johnbaikie/desk-hud/doc/img/preview_launches_recent.png

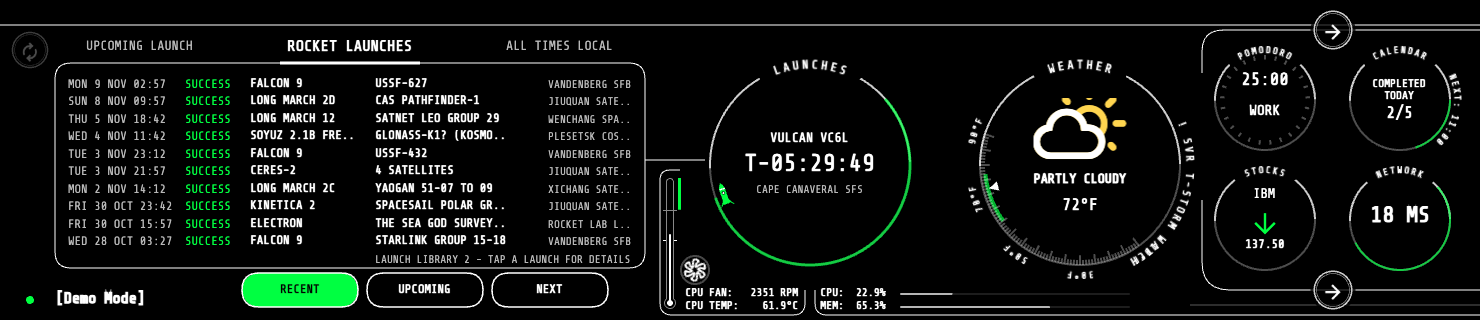
doc/img/preview_launches_recent.png
