johnbaikie/desk-hud/doc/stl/desk-hud-stand-lens-down.stl

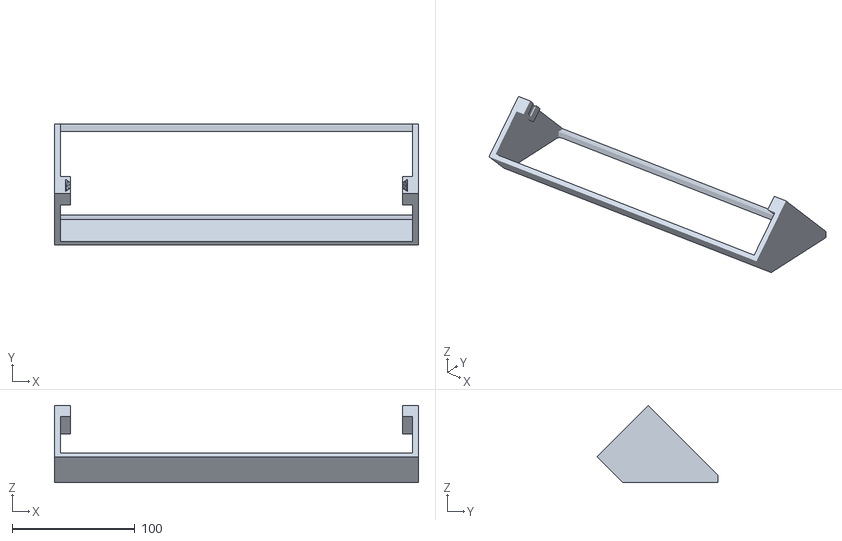
[picture p31: CAD file, 2026-11-07]
doc/stl/desk-hud-stand-lens-down.stl
297.0 x 98.8 x 62.9
