johnbaikie/desk-hud/doc/stl/desk-hud-stand-bar-fit-test.stl

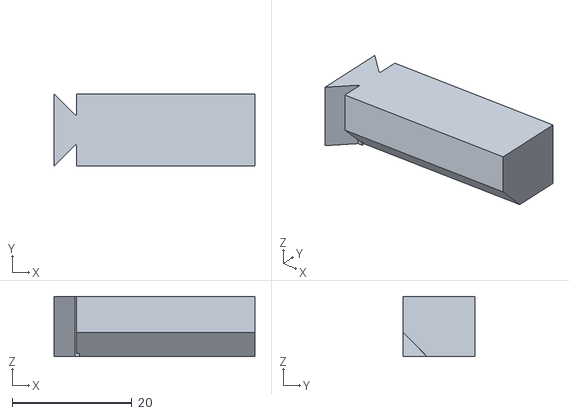
[picture p32: CAD file, 2026-11-07]
doc/stl/desk-hud-stand-bar-fit-test.stl
33.5 x 12.0 x 10.0
