johnbaikie/desk-hud/(commit log)

2026-10-27 Always use mocked distance sensor (no GPIO sensor installed)
2026-10-28 Change grey outline lines to white
    Border frame, room preview, covers diagrams, fan turbines, calendar
    divider and forecast separators now draw in white. Chart gridlines,
    dark border bars, grey text and fills are unchanged.
2026-10-28 Remove decorative hex counters from main screen
    The status labels regenerated a random hex string every frame,
    forcing two text re-renders and texture uploads per frame. They now
    stay blank unless statusLeftText/statusRightText is set.
2026-10-28 Switch to Share Tech Mono font with white uppercase text
    Replace the decorative Major Mono Display font with the more readable
    Share Tech Mono (bundled locally). Make all text white and render it
    uppercase to match the previous HUD look.
2026-10-28 Add create-widget skill and fix widget guide
    - Add .claude/skills/create-widget with templates, registration steps,
    current visual style, config handling and verification workflow
    - Point to the skill from CLAUDE.md
    - Fix widget guide: use Chart (style 'bars') instead of nonexistent
    BarChart, and the ShareTechMono font
2026-10-28 Fix right-side widgets ignoring taps after an interrupted drag
    ScrollContainer and TimezonePreview enlarged their invisible hit box
    100x on pointerdown and only shrank it on pointerup. If the touch was
    cancelled or the screen removed mid-drag, the box stayed enlarged and
    swallowed all taps to the right of it. Track drags with
    globalpointermove instead, and end them on pointerup, pointerupoutside,
    pointercancel and removal.
2026-10-31 Align calendar day highlight with the current font and fix Sunday-start months
    The highlight used fixed spacing tuned for the old MajorMono font, so it
    drifted off the current day with ShareTechMono. Measure the font instead.
    Months starting on a Sunday also put day 1 under Monday.
2026-10-31 Add optional Fahrenheit units to the weather widget
    weather.units ("metric" or "imperial") selects the OpenWeatherMap units,
    the temperature labels and a matching dial range. Configs without it stay
    in Celsius.
2026-10-31 Show the next pomodoro session and add a skip button
    When idle the timer shows the session play will start ("next: break")
    instead of the one that just ended. Skip switches to the other session,
    cancelling a running one; stop now resets the same session. Old saved
    timer state is converted on load. Note timer state and the Google
    widgets in CLAUDE.md.
2026-10-31 Show the Pi 5 cooler's speed instead of a GPIO fan mode
    The fan on the Pi 5 fan header is controlled by the firmware, so read its
    speed and duty from the pwm-fan hwmon device and show it in the system
    panel. Remove the off/auto/on GPIO 14 fan switching and its tap control.
2026-10-31 Support several stock symbols, rotating every 20 minutes
    stockdata.symbol may be a list. Quotes for all symbols come from one
    request; daily history is fetched per symbol every 6 hours to stay within
    the free plan. The widget and history chart show one stock at a time,
    switching every 20 minutes, and the chart rescales for each stock.
    Restarts only refetch stale data.
2026-11-03 Switch the accent colour from Tron blue to Matrix green
    Replace 0x00d8ff with 0x00ff41 everywhere; text and lines stay white.
    Draw today's date in black over the green calendar highlight so it stays
    readable.
2026-11-03 Deploy to the Pi by its reserved IP and document the Pi setup
    deskhud.local does not resolve over mDNS on this network; the Pi now has
    a DHCP reservation. Note the pm2 watch scope, log rotation, Wi-Fi power
    saving and fan readout in CLAUDE.md.
2026-11-03 Remove touch diagnostics and the blank widget; document touch calibration
    The right-hand widgets ignored taps because touch was not rotated with the
    display; a libinput calibration matrix in the Pi's labwc rc.xml fixes it.
    The widget count was not the cause, so the blank placeholder goes too.
2026-11-03 Replace the stock chart with current figures and swipe between stocks
    The enlarged Stocks screen shows the selected stock's price, change since
    open, open/high/low, previous close, volume and 6-month range. Swiping up
    or down moves to the next or previous stock; the small circle follows the
    selection and still advances after 20 minutes without a swipe. The
    service passes the extra quote fields through.
2026-11-03 Save memory: simulate the distance sensor in-process, trim logs from cron
    The mock distance sensor ran as its own node process (~45 MB) printing a
    constant reading; push the readings from a timer in DistanceService
    instead. Add scripts/trim-pm2-logs.sh, run hourly from cron, to replace the
    pm2-logrotate module (~75 MB resident).
2026-11-03 Swipe the calendar main screen to see other days
    Swiping left/right on the Calendar or Outlook main screen moves through
    the next six days; the title shows the day and it returns to today after
    a minute. The Google service now loads a full week (timeMax, up to 250
    events) so later days aren't cut off.
2026-11-04 Add Rainbow Mode to the Accent widget: a random color per widget
    ACCENT is now a live binding that index.js switches before building each
    widget; components that draw after construction keep a copy of it.
2026-11-04 Add a Network widget: Wi-Fi signal, pings, DNS, dropouts and speed
    NetworkService samples every 30 s with local tools (ip route, ping to the
    router and 1.1.1.1, dns.lookup of the hosts the other services use,
    /proc/net/wireless), keeps 24 h of history in node-persist and runs a
    10 MB Cloudflare download test every 3 hours or on demand.
2026-11-05 Restyle outlines: rounded panel, pill tabs, smooth circles
    Replace the angular, notched frames with rounded shapes: a rounded main
    panel, pill-shaped tab buttons in one row, border lines with rounded
    corners instead of 45-degree jogs and zigzags, smooth widget circles
    without the |> <| title markers, and solid rounded progress bars.
    LineArt gains addRoundedSequence/roundCorners so lines still draw in.
2026-11-05 Show a sun-lit world map on the Date & Time TIME tab
    Replace the timezone strips with a dot-matrix world map (Natural Earth
    110m land, packed into a 1 KB bitmask): land is lit by the current sun
    position with a day/night line and a subsolar marker, home and the
    configured zones are marked with their local times, and home's sunrise,
    sunset and day length are shown. The server now sends the weather
    location as dateTime.location for the home marker.
2026-11-06 Add the Moon to the TIME tab's world map
    Show the current phase (picture, name, illumination and days to the next
    full or new moon) above home's sunrise and sunset, and mark the point
    where the Moon is overhead, drawn in its phase. Positions and phase come
    from the main terms of the lunar theory (about a degree).
2026-11-07 Add the 3D printed stand: guide, OpenSCAD source, STLs and images
    Adds doc/install_stand.md, the parametric doc/scad/desk-hud-stand.scad
    with a Makefile that exports every STL and runs the interference checks
    (collide, joint, clips_collide all pass), the six STLs in doc/stl and
    the guide's images. doc/install_case.md links to the new guide.
2026-11-07 Make the docs my own: new screenshots, README, setup guides and demo site
    - README rewritten for this version: every current widget with fresh
    demo-mode screenshots, a link to my demo, build/dev links and credits
    to the original project (MIT notice kept in LICENSE, my line added)
    - scripts/capture-screenshots.mjs regenerates the screenshots from the
    demo build at 1480x320 with a fixed clock (demo exposes window.deskHud)
    - Hardware and software guides rewritten for the Pi 5 / Trixie / labwc
    setup; scripts/setup-auto-updates.sh added for nightly OS updates
    - .github/workflows/demo.yml publishes the demo build to GitHub Pages
    - package.json and clone URLs point at johnbaikie/desk-hud; o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
2026-11-07 Add a Formula 1 widget: driver and constructor standings and the next race
    Data from Jolpica-F1 (the free Ergast successor, no key), refreshed hourly.
    Tabs for drivers, teams and the next race weekend with a countdown; the
    circle shows the championship leader and the season's progress. The
    screenshot script can now capture a subset of shots.
2026-11-07 Add an F1 car to the Formula 1 widget
    A small drawn car in the accent colour drives round the inside of the
    season-progress ring to the current round, and a larger one sits by the
    next race's countdown.
2026-11-07 F1 widget: browse the season's race weekends and every session's results
    The RACES tab (was NEXT RACE) shows one weekend at a time; swipe through
    the season. INFO keeps the circuit, countdown and session times; P1, P2,
    P3, SQ, SP, Q and GP show that session's classification from OpenF1
    (free historical data), matched to the Jolpica calendar by session type
    and start time. Results are fetched on request, spaced for OpenF1's rate
    limit and cached once a session is over. Demo mode gets the 2026
    calendar and made-up results.
2026-11-11 Switch off the Google features, keeping their code
    src/widgets/features.json gains a "google" switch, off for now because
    the Google project is unpublished and its sign-in expires weekly. Off, it
    leaves out the Tasks widget, the Google Calendar and Tasks services and
    the Calendar's Personal tab; the demo and screenshot script follow it.
2026-11-11 Add a Bambu Lab printers widget: print progress over LAN MQTT
    BambuService connects to each printer in bambu.printers (mqtts :8883,
    access code), merges its status reports and sends progress, layers,
    time left, temperatures and AMS slots. View only: it sends nothing but
    pushall. The widget shows one printer on the circle, details on the
    main screen, swipes between printers and comes forward when a print
    finishes or fails.
    Claude-Session: https://claude.ai/code/session_01XdbDRapd7Bo4fxC5hppvxQ
2026-11-11 Put the Printers widget after Word of the Day, not in front
    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
2026-11-12 Listen on localhost only, so the LAN can't reach the HUD's socket
    The page, its socket.io endpoint (which accepts service commands and
    streams the backend log) and livereload listened on every interface.
    The kiosk browser runs on the Pi itself, so they now bind to core.host,
    127.0.0.1 by default; "0.0.0.0" opens them to the network again.
    livereload has no host option, so its server is built without listening
    and then listens on the chosen host.
2026-11-12 Printers: leave a gap at the top of the progress arc for the title
    The arc started at 12 o'clock and ran through the widget's title on the
    side galleries. It now starts 0.85 rad round, as on Network, F1 and
    Sports, and a full print fills the span up to the other side of the gap.
2026-11-12 Add a Wi-Fi watchdog and persistent journal setup for the Pi
    Since the Nov 10 Wi-Fi firmware update the Pi's Wi-Fi drops and stays
    down until a reboot. scripts/pi/install.sh installs a systemd timer that
    pings the router every 30 s over wlan0 and reconnects, reloads brcmfmac
    or (rarely) reboots when it stops answering, and keeps the journal on
    disk so the cause of a drop survives a reboot. CLAUDE.md records this
    and the PMF and roaming changes made on the Pi.
2026-11-14 Launches: add an ORBIT tab with live positions from CelesTrak
    The ORBIT tab shows the ISS, Tiangong and recent launches' payloads on
    the dot world map, with the picked object's ground track, height, speed,
    sunlight or shadow, and the stations' next pass over home. The service
    reads CelesTrak every two hours (OMM JSON, since new objects have
    six-digit catalogue numbers TLEs can't hold, plus the SATCAT) and
    matches recent launches to their objects by designator or by launch
    date and site; the browser propagates them with satellite.js 6.0.2.
    UPCOMING and RECENT now share the LAUNCHES tab, with buttons to switch.
    LL2's "Deployed" status counts as launched, and a launch LL2 lists as
    previous no l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
